anushadatar/yes-we-pan/lab2_kelley_datar.pdf

# 3D Scanner - Time of Flight Edition

## Anusha Datar Quinn Kelley

## September 25, 2018

# 1 Overview

The objectives of this lab were to develop a simple 3D scanner that utilized a pan/tilt mechanism and used it to visualize the results of scanning a known object. We decided to trial the experimental version of this lab, which replaced the infrared distance sensor with a time-of-flight sensor and required that we

scan a convex object instead of a known surface.

# 2 CAD

We designed the housing for this model in SolidWorks, and we took care to tolerance the model by several millimeters to ensure a proper fit. Then, we 3D printed it. We experienced our first problem at this stage: because we lacked experience with print settings, we selected twenty percent infill, and our printed parts were quite weak. Another issue was that the arm that held the ”tilt” servo was printed sideways with no support material, so it experienced slight deformation. Nevertheless, the pieces fit fairly well and the assembly held up

through many scans.

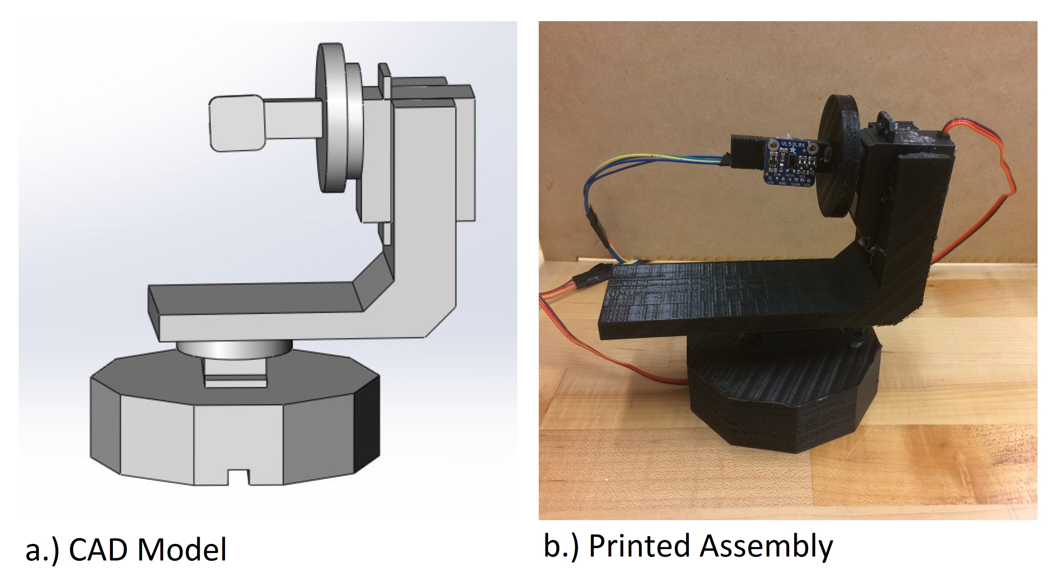
[picture p1: figure]

## Figure 1: Pan/Tilt System

1

# 3 Circuit

A standard Arduino Uno was used as the central processing and power distribu-tion unit for this scanner. The actuators for the pan and tilt functionality were both Vigor Precision VS-2MB servo motors driven by digital pins. The sensing unit, an Adafruit Time of Flight LIDAR sensor, used I2C communication to relay information to the Arduino. See Appendix A.1 for a full circuit diagram

and Appendix A.2 for an image of the circuit.

# 4 Calibration

We determined the relationship between a target object’s distance and the sensor’s voltage by configuring the sensor to print values averaged over a known time to the Serial console, holding a board at various known distances away from the sensor and recording the output, and then fitting the curve in MAT-LAB (see Figure 2). We then took several distances, used the calibration curve to predict the output voltage, and then measured the actual voltage to validate our model. Plotting this (Figure 3) showed us that our calibration curve was fairly accurate, as the test data points did not stray very far from the line, which had the equation V oltage = 8.8 ∗ (distance in mm) + 80 We used this equation

in our python script to find the radial distance measured by the sensor.

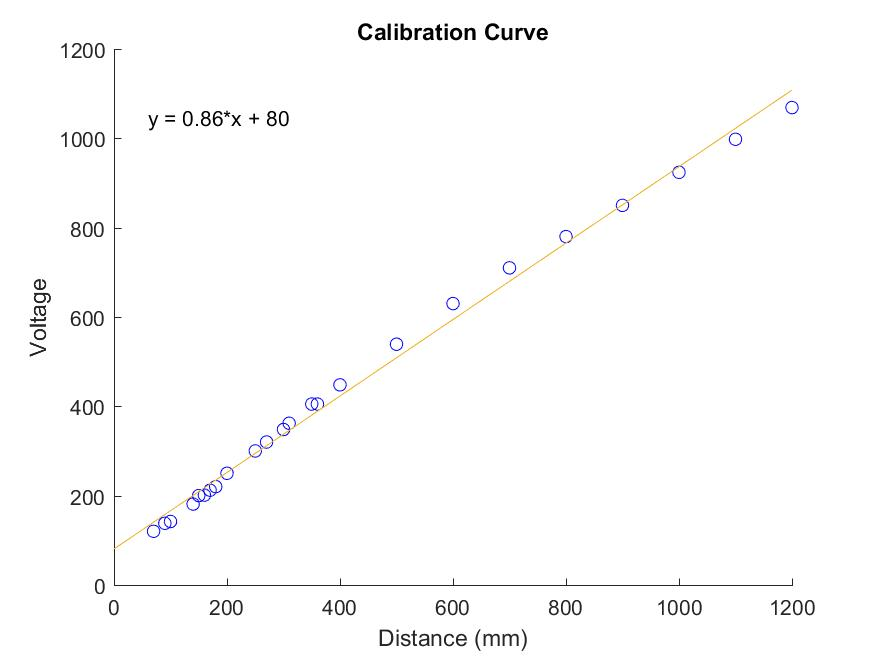
[picture p2: figure]

## Figure 2: Sensor Calibration Curve

2

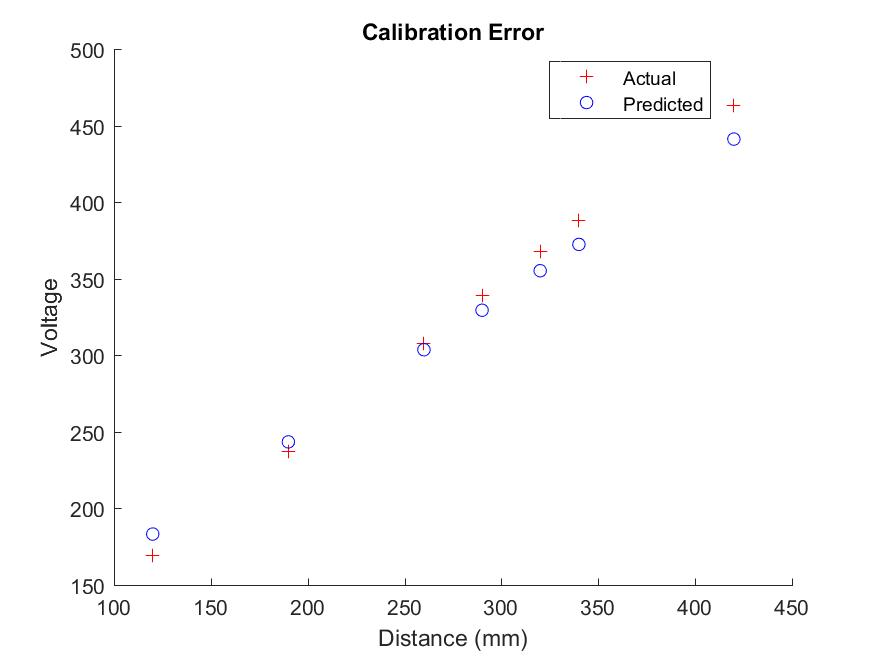
[picture p3: figure]

## Figure 3: Calibration Error Curve

# 5 Software

The software associated with this lab contains two distinct sections: the Arduino code for the scanner itself and the python code to process the data. On the Arduino, the user specifies the ranges for both of the motors, and the Arduino directs the servo to begin at the minimum point for each motor, sweep all possible points within that range, and take the angle of each servo and the distance from the time-of-flight sensor at each step and transmit it over serial so it can be processed on a laptop by the python script. See Appendix B.1 for

Arduino source code.

The goal of the python script was to take the Arduino data from the serial port, process it, and generate a three-dimensional visualization of the scanned object. We made a main python script to receive and process a data and a utilities module with conversion and plotting functions. Overall, the script processes the incoming serial data, which is in spherical coordinates, adjusts the angles to place the center of the scanning cone at the origin, and it converts the spherical coordinates to cartesian coordinates using the equations:

X = ρ ∗ sinφ ∗ cosθ | (1)
Y = ρ ∗ sinφ ∗ sinθ | (2)

3

Z = ρ ∗ cosφ | (3)

where the radial distance of the sensor ρ = (8.6∗Measured Distance in mm+80),

## which was the empirical calibration curve. In order to account for the reversal of the azimuth due to the initial sensor placement, φ = Sensor longitude angle−

120 ◦

## . To shift to the correct range in latitude, T heta = latitude angle − 120 ◦

## The coordinate points were finally visualized using the matplotlib 3D scatter

plot feature. See Appendix B.2 for Python source code.

# 6 Results

We chose to scan this mug, expecting to see a cylindrical shape for the base,

a vague outline of the handle, and some general distortion due to the mug’s reflectiveness. Our results matched our predictions : we could recognize the handle and the general shape of the mug, but were not able to create the cleanest possible image. We also scanned the mug in front of a wall and were able to

see the difference between the points on the wall and the points on the mug,

## suggesting that all possible points were selected and properly mathematically

processed.

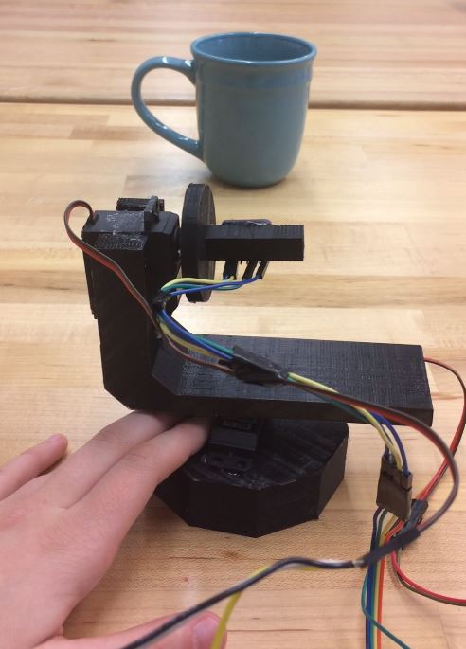
[picture p4: figure]

## Figure 4: Scanning setup

4

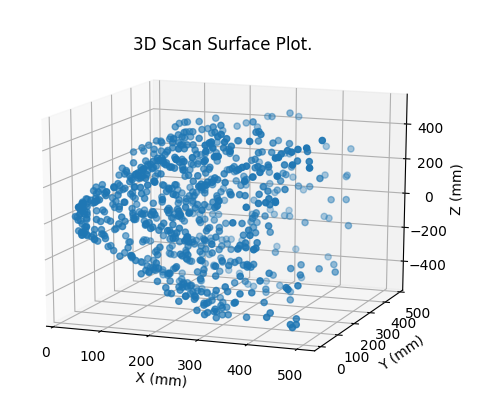
[picture p5: figure]

## Figure 5: 3D scan of the Mug

# 7 Reflection

There were a few major lessons that we learned while completing this lab. We worked with serial and python, which was an interesting departure from exclu-sively Arduino-based processing. We especially gained experience with serial because we had a mysterious problem with the serial output where the output would stop sending data and only continue to transmit if we cleared the buffer: finding and debugging this issue was a frustrating and informative learning experience. We also learned to be more conscious about our data collection and processing methods: because of timing issues, we had a few jarring outliers in some of our test cases, which became confusing when we tried to interpret our data. Once we discovered them, found their causes (i.e. timing issues with the I2C input from the sensor), and eliminated them, our project went much more smoothly. A last problem we faced was with 3D printer settings - we used twenty percent infill and did not add as many supports as were necessary, so our parts were weak and we had to exercise caution with them - at the same

time, we gained experience, and will not make the same mistakes in the future.

As for our thoughts on the experimental portion of this lab, we do not feel like our learning experience was divergent from the infrared sensor lab, but we do feel as though we had to deal with more (relatively) arbitrary roadblocks: the I2C protocol created a few issues, even with the Adafruit library, the results were hard to interpret and the measurements were not very clean, and the difficulty of finding an adequate convex object (such that we could confirm that

the orientation was correct and that was not too reflective).

5

# A Appendix A

## A.1 Circuit Diagram

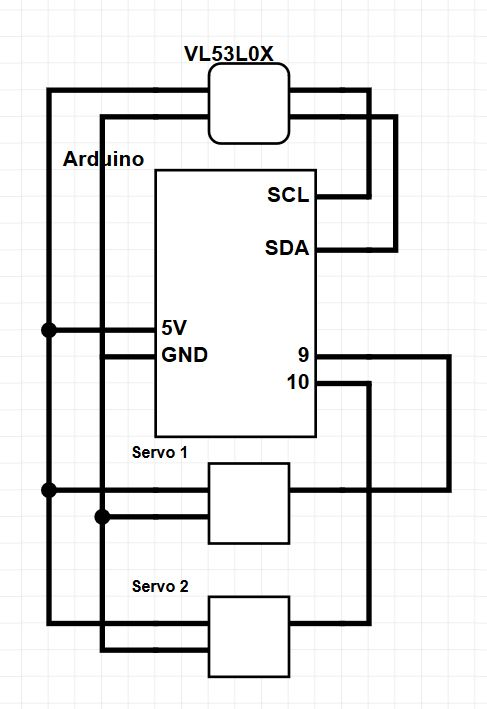
[picture p6: figure]

## Figure 6: Circuit diagram

6

## A.2 Circuit Image

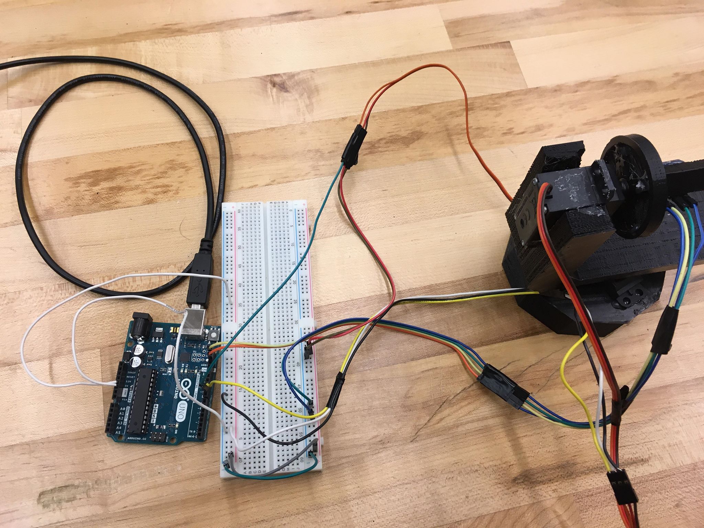
[picture p7: figure]

## Figure 7: Circuit Image

# B Appendix B

B.1 | Arduino Source Code
1 | * Transmits servo angle and distance sensor data
2 | * for each servo step over serial for further
3 | * analysis. This code is intentionally generic and lightweight
4 | * as all processing occurs onboard a laptop with python instead
5 | * of on the microcontroller.
6 | */

7
8 | // Grab the libraries for the time-of-flight sensor and for the servos.
9 | #include "Adafruit_VL53L0X.h"
10 | #include "Servo.h"

11
12 | // The sensor works over I2C, so no need to worry about pin mappings for that.
13 | Adafruit_VL53L0X lox = Adafruit_VL53L0X();
14 | // Servos need pin mappings, declarations, bounds, and position counters.
15 | // Keeping naming conventions generic to emphasize post-processing.
16 | Servo servoA;
17 | Servo servoB;
18 | int servoApin = 9;
19 | int servoBpin = 10;
20 | int servoApos = 0;
21 | int servoBpos = 0;

22
23 | int servoAmin = 45;
24 | int servoAmax = 135;
25 | int servoBmin = 45;
26 | int servoBmax = 100;

7

27
28 | void setup() {
29 | // Kick off Serial. Be sure to match baudrate on python script.
30 | Serial.begin(9600);
31 | while (! Serial) {
32 | delay(1);
33 | }
34 | // Make sure that the sensor boots before moving any motors.
35 | if (!lox.begin()) {
36 | // DEBUG
37 | // Serial.println(F("Failed to boot VL53L0X"));
38 | while(1);
39 | }
40 | // DEBUG
41 | // Serial.println(F("Booted sensor."));
42 | // Declare servos.
43 | servoA.attach(servoApin);
44 | servoB.attach(servoBpin);
45 | // Confirm that the servos go home.
46 | zero_servos();
47 | }

48
49 | void loop() {
50 | /*
51 | * Print a consistent data structure of distance measurement and each servo position
52 | * over serial so it can be processed by the python script. The format should be
53 | * [DISTANCE_READ (mm), SERVOA_ANGLE, SERVOB_ANGLE]
54 | */
55 | VL53L0X_RangingMeasurementData_t measure;

56
57 | for (servoApos = servoAmin; servoApos <= servoAmax; servoApos += 1) {
58 | servoA.write(servoApos);
59 | delay(15);
60 | for (servoBpos = servoBmin; servoBpos <= servoBmax; servoBpos += 1) {
61 | servoB.write(servoBpos);
62 | delay(15);
63 | // Send data from the sensor if there is no phase failure. Otherwise, just
64 | // move on to the next angle because we can try to interpolate in post.
65 | lox.rangingTest(&measure, false); // pass in ’true’ to get debug data printout!
66 | if (measure.RangeStatus != 4) {
67 | // Sends appropriate values over serial.
68 | Serial.print("Distance: ");
69 | Serial.print(measure.RangeMilliMeter);
70 | Serial.print(" ");
71 | Serial.print(servoApos);
72 | Serial.print(" ");
73 | Serial.print(servoBpos);
74 | Serial.print("\n");
75 | }
76 | }
77 | }
78 | // Continue for multiple scans if appropriate.
79 | delay(500);
80 | zero_servos();
81 | delay(100);
82 | }

83

8

84 | void zero_servos() {
85 | /*
86 | * Bring servos back to their original positions at the start of processing.
87 | */
88 | servoA.write(servoAmin);
89 | delay(15);
90 | servoB.write(servoBmin);
91 | delay(15);
92 | delay(200);
93 | }
B.2 | Python Source Code

## We also created two Python programs with which to process the data - a quick program to process data from the serial port and a utilities file with function

implementations.

B.2.1 | Serial Processing File
1 | #!/usr/bin/env python3
2 | # Quinn Kelley and Anusha Datar
3 | # Principles of Engineering Lab 2
4 | # Serial-based processing test file.

5
6 | """
7 | Listens to arduino over serial port to collect data to generate visualization.
8 | Uses functions from utilities file.
9 | """
10 | from utilities import *
11 | import serial
12 | import time

13
14 | # Substitue in port number of the arduino. On most UNIX-based systems, the
15 | # arduino will be at "/dev/ttyACMO" and on most Windows machines it will be
16 | # at a COM port location.
17 | PORT = "/dev/ttyACM0"
18 | # Set the baudrate. This must match baudrate on the arduino program.
19 | BAUD = 9600

20
21 | # A list of all the cartesian points generated to plot later.
22 | points = []
23 | serialPort = serial.Serial(PORT, BAUD, timeout=10)
24 | # Whether or not the scan has ended, based on servo angles from arduino code.
25 | scanContinue = True

26
27 | while scanContinue:
28 | try:
29 | data = serialPort.readline().decode().split()
30 | time.sleep(1);
31 | if len(data)==4:
32 | # Use the servo bounds from the arduino program. It could be cool
33 | # to have the arduino send a calibration message during setup
34 | # and grab those rather than harcoding them.
35 | if (int(cartesian_point[1]) == 120 and int(cartesian_point[2]) == 90):
36 | scanContinue = False
37 | cartesian_point = spherical_to_cartesian(cartesian_point)

9

38 | # Sometimes, because of timing difficulties, the sensor will send
39 | # out erroneous values, and these numbers will create huge outliers
40 | # that make the plots difficult to read. Eliminate these.
41 | valid_point = True
42 | for element in cartesian:
43 | # Threshold empirically determined; object under study was
44 | # much closer than this.
45 | if abs(element) > 600:
46 | valid_point = False
47 | if valid_point:
48 | points.append(cartesian_point)
49 | except:
50 | # If something gets cut off on a measurement, move on to the next
51 | # received message, but wait to minimize residual errors.
52 | time.sleep(.5)
53 | continue

54
55 | # Plot points following data collection.
56 | create_three_dimensional_plot(points)
B.2.2 | Utilities File
1 | # Utilities file.
2 | """
3 | Because of shared functions with File IO and serial-based communication, this
4 | file proved to be a valuable resource to maintain a consistent architecture
5 | throughout test phases.
6 | """
7 | import math
8 | import matplotlib.pyplot as plt
9 | from mpl_toolkits.mplot3d import Axes3D
10 | import serial
11 | import time

12

13
14 | def spherical_to_cartesian(point):
15 | """
16 | Converts spherical point from pan/tilt mechanism into cartesian points.
17 | Note that it assumes a 0 to 120 servo-angle based cone for scanning and
18 | employs an empiricially determined calibration curve to find the radial
19 | distance measured by the sensor.

20
21 | point : A list as follows:
22 | [DISTANCE_MEASUREMENT, LATITUDE_ANGLE, LONGITUDINAL_ANGLE]
23 | returns : A list with the cartesian point equivalent of the input:
24 | [X, Y, Z]
25 | """
26 | distance = 8.6*int(point[0]) + 80
27 | # Our current angles are from 60 degrees to 120 degrees. Shift those
28 | # to be between -60 and 60 degrees.
29 | theta = int(point[1]) - 120
30 | # Subtract 120 + 90 from this one to account for reversal of azimuthal
31 | # direction because of existing sensor orientation.
32 | phi = int(point[2]) - 120
33 | # Spherical coordinate formula.
34 | x = distance*math.sin(math.radians(phi + 180))*math.cos(math.radians(theta))
35 | y = -distance*math.sin(math.radians(phi + 180))*math.sin(math.radians(theta))
36 | z = distance*math.cos(phi)

10

37 | cartesian_point = [x, y, z]
38 | return cartesian_point

39
40 | def create_three_dimensional_plot(points):
41 | """
42 | Creates three dimensional visualization of data collected from scan.

43
44 | points : List of lists where each sub-list is a cartesian point
45 | [X, Y, Z]
46 | """
47 | fig = plt.figure()
48 | ax = fig.add_subplot(111, projection=’3d’)
49 | x_values = []
50 | y_values = []
51 | z_values = []
52 | for element in points:
53 | x_values.append(element[0])
54 | y_values.append(element[1])
55 | z_values.append(element[2])
56 | # Use the matplotlib 3D plot feature.
57 | ax.scatter(xs=x_values, ys=y_values, zs=z_values)
58 | ax.set_title("3D Scan Surface Plot.")
59 | ax.set_xlabel("X (mm)")
60 | ax.set_ylabel("Y (mm)")
61 | ax.set_zlabel("Z (mm)")
62 | plt.show()

63
64 | def create_three_dimensional_surface(points):
65 | """
66 | Creates three dimensional visualization of data collected from scan.

67
68 | points : List of lists where each sub-list is a cartesian point
69 | [X, Y, Z]
70 | """
71 | fig = plt.figure()
72 | ax = fig.add_subplot(111, projection=’3d’)
73 | x_values = []
74 | y_values = []
75 | z_values = []
76 | for element in points:
77 | x_values.append(element[0])
78 | y_values.append(element[1])
79 | z_values.append(element[2])
80 | # Use the matplotlib 3D plot feature.
81 | ax.plot_trisurf(x_values, y_values, z_values)
82 | ax.set_title("3D Scan Surface Plot.")
83 | ax.set_xlabel("X (mm)")
84 | ax.set_ylabel("Y (mm)")
85 | ax.set_zlabel("Z (mm)")
86 | plt.show()

11
