anushadatar/yes-we-pan/(commit log)

2018-09-15 Added arduino framework
2018-09-18 they said i couldn't make my arduino code more pythonic.. they were wrong
